jpconstantineau/ErgoTravel/(notices)

Notices in the files:
PCB_Choc_LED/ErgoTravel.kicad_pcb:
Copyright 2019 - MIT License
PCB_Choc/ErgoTravel.kicad_pcb:
Copyright 2018 - MIT License
PCB/ErgoTravel.kicad_pcb:
Copyright 2018 - 2021 - MIT License
